manuel-io/adconv/(list of files, drawings)

Other design files:
share/adconv.pcb
share/x.pcb
