manuel-io/adconv/(commit log)

2016-08-14 Schematics aka logical structure
    [adconv.sch]
2016-08-20 ADC code
    [adconv.sch]
2016-08-21 ADConv layout
    [adconv.pcb]
2016-08-28 Layout v2.0
    [adconv.sch, x.pcb]
2016-09-03 Upcoming new version
    [adconv.pcb]
2016-09-24 UART timeout routine
2016-10-02 ISP/SPI & XConn graphics
2016-10-02 Flow ctrl: Enable/disable web interface & Misc
2016-10-02 Power saving
